rjafari44/Epione_Robot_Arm/ltspice/arm_schematic.asc

X1: Arduino_Mega
X2: CNC_Shield
X3: CNC_Shield
X4: Stepper_Motor
X5: Stepper_Motor
X6: Stepper_Motor
X7: Stepper_Motor
X8: Stepper_Motor
X9: Stepper_Motor
X10: Joystick
X11: Servo_Motor
X12: Buck_Converter
X13: Switch
Named nets: +24V, 0, D6, Supply_In, X, D36, D37, D34, D35, D38, D39, D40, D41, D42, D43, D44, D45, D7, A7, +5V, VRx, 5V, Y_STEP1, A_STEP1, X_STEP2, Y_STEP2, Z_STEP2, A_STEP2, Y_DIR1, A_DIR1, X_DIR2, Y_DIR2, Z_DIR2, A_DIR2, PWM, SW, PC_5V+
1
2
CNC Shield 2 + Motors
CNC Shield 1 + Motors
Microcontroller
Joystick/Control
Input Situation + Buck and Servo Motor
