rjafari44/Epione_Robot_Arm/(commit log)

2026-02-26 added the logic for moving the arm
2026-03-01 slowed down motor 5 in manual mode a little bit
2026-03-01 slowed down the base motor a bit more
2026-03-01 slowed down base motor even more
2026-03-01 fixed the floating pin issue
2026-03-01 added cad files
2026-04-20 updated schematic file and image
2026-04-30 slowed down motors and updated shell scripts
